mantellian/chargriller-980-controller/KiCad/chargriller-980.kicad_sch

## KiCad design KiCad/chargriller-980.kicad_sch (2025-12-09)

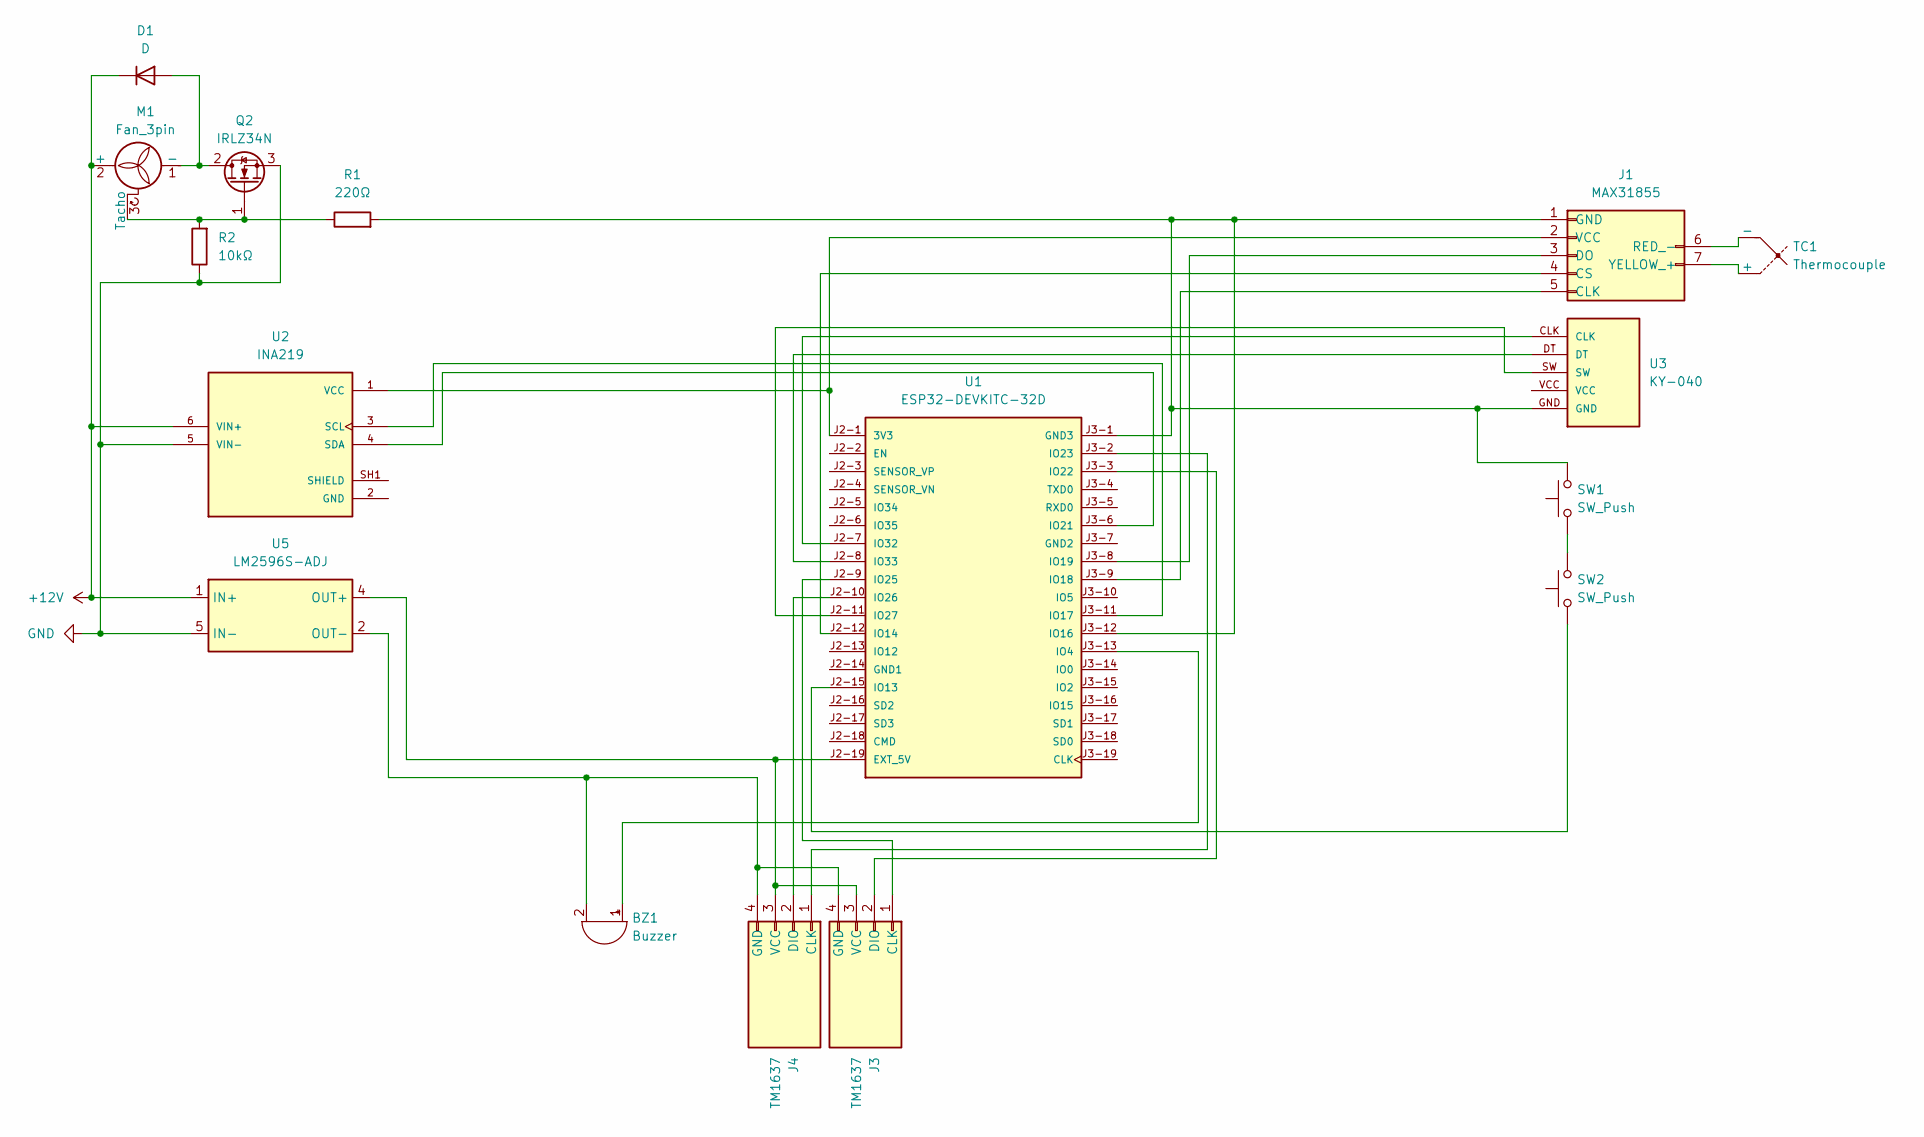
[picture p1: schematic chargriller-980.kicad_sch]

Parts:
BZ1: Buzzer
D1: D
J1: MAX31855
J3, J4: TM1637
M1: Fan_3pin
Q2: IRLZ34N; TO-220-3_Vertical
R1: 220Ω
R2: 10kΩ
SW1, SW2: SW_Push
TC1: Thermocouple
U1: ESP32-DEVKITC-32D; MODULE_ESP32-DEVKITC-32D; PARTREV V4
U2: INA219; MODULE_INA219; PARTREV C
U3: KY-040; KY-040-PORT
U5: LM2596S-ADJ; TO-263-5_TabPin3

Connections:
+12V: D1.1 (K), M1.2 (+), U2.6 (VIN+), U2.VIN+, U5.1 (IN+)
GND: Q2.3 (S), R2.1, U2.5 (VIN-), U2.VIN-, U5.5 (IN-)
unnamed: BZ1.1 (+), U1.J3-13 (IO4)
unnamed: BZ1.2 (-), J3.4 (GND), J4.4 (GND), U5.2 (OUT-)
unnamed: D1.2 (A), M1.1 (-), Q2.2 (D)
unnamed: J1.1 (GND), R1.2, SW1.2, U1.J3-1 (GND3), U1.J3-12 (IO16), U3.GND
unnamed: J1.2 (VCC), U1.J2-1 (3V3), U2.1 (VCC)
unnamed: J1.3 (DO), U1.J3-8 (IO19)
unnamed: J1.4 (CS), U1.J2-12 (IO14)
unnamed: J1.5 (CLK), U1.J3-9 (IO18)
unnamed: J1.6 (RED_-), TC1.2 (-)
unnamed: J1.7 (YELLOW_+), TC1.1 (+)
unnamed: J3.1 (CLK), U1.J2-9 (IO25)
unnamed: J3.2 (DIO), U1.J3-3 (IO22)
unnamed: J3.3 (VCC), J4.3 (VCC), U1.J2-19 (EXT_5V), U5.4 (OUT+)
unnamed: J4.1 (CLK), U1.J3-2 (IO23)
unnamed: J4.2 (DIO), U1.J2-10 (IO26)
unnamed: M1.3 (Tacho), Q2.1 (G), R1.1, R2.2
unnamed: SW1.1, SW2.2
unnamed: SW2.1, U1.J2-15 (IO13)
unnamed: U1.J2-7 (IO32), U3.CLK
unnamed: U1.J2-8 (IO33), U3.DT
unnamed: U1.J2-11 (IO27), U3.SW
unnamed: U1.J3-6 (IO21), U2.4 (SDA)
unnamed: U1.J3-11 (IO17), U2.3 (SCL)
unnamed: U2.SH1 (SHIELD), U2.SH2 (SHIELD), U2.SH3 (SHIELD), U2.SH4 (SHIELD)
