mantellian/chargriller-980-controller/(commit log)

2025-06-24 BOM update
2025-06-24 KiCad update
    [wiring_diagram.kicad_pcb, wiring_diagram.kicad_sch]
2025-11-16 Update and rename chargriller.yml to gravity980.yml
2025-11-16 Add comments for antenna and power save mode
    Added comments for external antenna and power save mode.
2025-11-16 Revise BOM for Gravity 980 ESP32 Controller
    Updated the Bill of Materials for the CharGriller 980 ESP32 Controller. Added required and optional components, and reorganized sections for clarity.
2025-11-16 Enhance README with clearer project details
    Updated README.md to improve clarity and detail in project goals, hardware components, features, and current status.
2025-11-16 Update BOM with new components and specifications
    Added additional components and specifications for connections, hardware, and future upgrades.
2025-11-16 Revise alert system details in BOM.md
    Updated alert system entry to specify an active piezo beeper with SOS alert pattern.
2025-11-16 Refactor alert script and rename buzzer to beeper
    Updated buzzer alert script to SOS pattern and changed buzzer to beeper.
    [gravity980.yml]
2025-11-16 Restore rotary encoder and add PID autotune button
    Reintroduce rotary encoder sensor configuration with updated logic for temperature adjustment and added PID autotune button.
2025-11-16 Enhance PID Autotune with disclaimer and logging
    Added a disclaimer for PID Autotune and updated the PID Autotune button functionality.
2025-12-04 Update gravity980.yaml
    fixed pin conflict
    [gravity980.yaml]
2025-12-05 Update ESPHome configuration for chargriller-980
    Refactor ESPHome configuration for chargriller-980, updating platform and adding new sensors, displays, and controls.
2025-12-05 Add ESPHome configuration for Chargriller 980
    This configuration file sets up the ESPHome firmware for the Chargriller 980 grill, including temperature control, alarms, and display settings.
2025-12-05 Modify ESP32 settings and pin configurations
    Updated ESP32 configuration and pin assignments.
2025-12-05 Add wiring chart for CharGriller-980
    Added detailed wiring chart for CharGriller-980, including power distribution, component connections, and wiring tips.
2025-12-05 Add current_fan_duty tracking for fan control
2025-12-05 Simplify fan PWM configuration
    Removed on_turn_on and on_turn_off actions for fan PWM.
2025-12-05 Add ESPHome configuration for Chargriller 980
    This configuration file sets up the ESPHome firmware for a Chargriller 980 grill, including temperature control, fan management, and alarm systems.
2025-12-05 Refactor configuration for clarity and functionality
    Updated various component names and properties in the configuration. Removed web server sorting for some components and adjusted alarm switch names.
2025-12-06 Implement PID control and enhance monitoring features
    Added PID control variables and logic for fan operation. Updated display and web server settings for PID control. Enhanced alarm monitoring for temperature and fan errors.
    [gravity980.yaml]
2025-12-06 fix(BOM): Relocate INA219 current sensor to 'Current Sensing' section
2025-12-06 fix(README): Correct wiring chart link and remove 'Last Updated' field
2025-12-07 fix(README): Update wiring chart link for new file structure
2025-12-07 refactor: Adjust file structure as per user preference
    [example.stl, wiring_diagram.kicad_pcb, wiring_diagram.kicad_sch]
2025-12-08 Adds KiCad project files
    [chargriller-980.kicad_sch]
2025-12-08 updates to KiCad files
    [chargriller-980.kicad_sch]
2025-12-08 further updates to KiCad schematic and remove auto_saved_files
    [chargriller-980.kicad_sch]
2025-12-08 updates to KiCad schematic and gitignore
    [chargriller-980.kicad_sch]
2025-12-09 feat: update KiCad files based on user changes
    [chargriller-980.kicad_sch]
